thimbleio/kit2-led-cube/README.md

The Thimble LED cube kit.

hadware/ - datasheets, PCB design files

learning/ - tutorial content, intended to be viewed on learning.thimble.io

software/ - code examples written for the Arduino IDE

For more info or to subscribe, visit http://www.thimble.io
