thimbleio/kit2-led-cube/hardware/PCB-Main/Cube Main Gerbers/Cube-Main-Ref.jpg

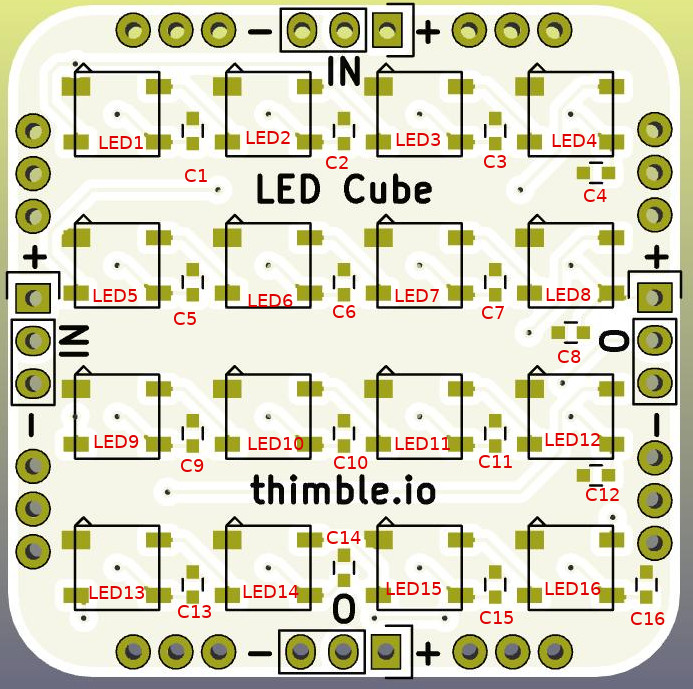
hardware/PCB-Main/Cube Main Gerbers/Cube-Main-Ref.jpg
