thimbleio/kit2-led-cube/hardware/PCB-Top/Cube Top Gerbers/Cube-Top-Ref.jpg

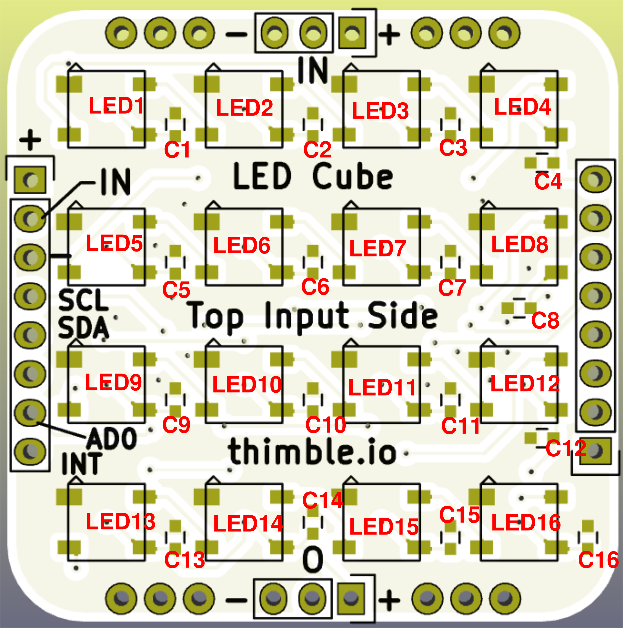
hardware/PCB-Top/Cube Top Gerbers/Cube-Top-Ref.jpg
