thimbleio/kit2-led-cube/learning/assets/images/screenshots/008/in-and-out.png

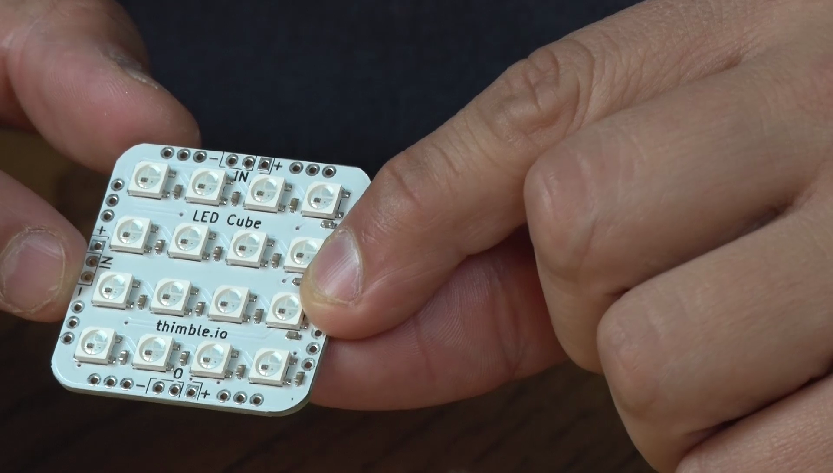
learning/assets/images/screenshots/008/in-and-out.png
