thimbleio/kit2-led-cube/learning/assets/images/thumbs/004.jpg

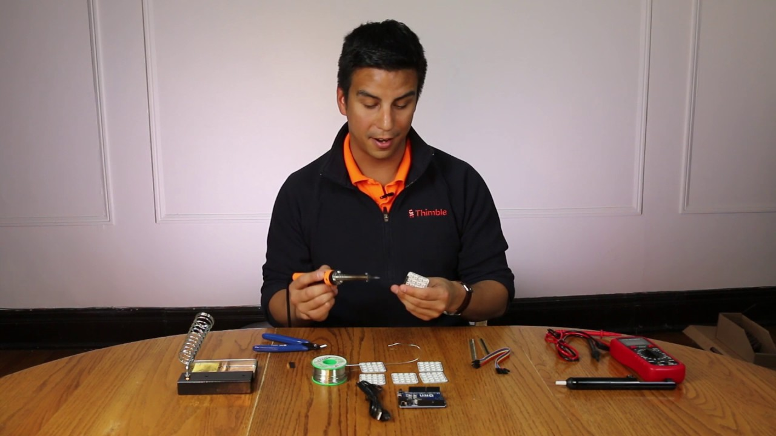
learning/assets/images/thumbs/004.jpg
