thimbleio/kit2-led-cube/learning/assets/images/thumbs/005.jpg

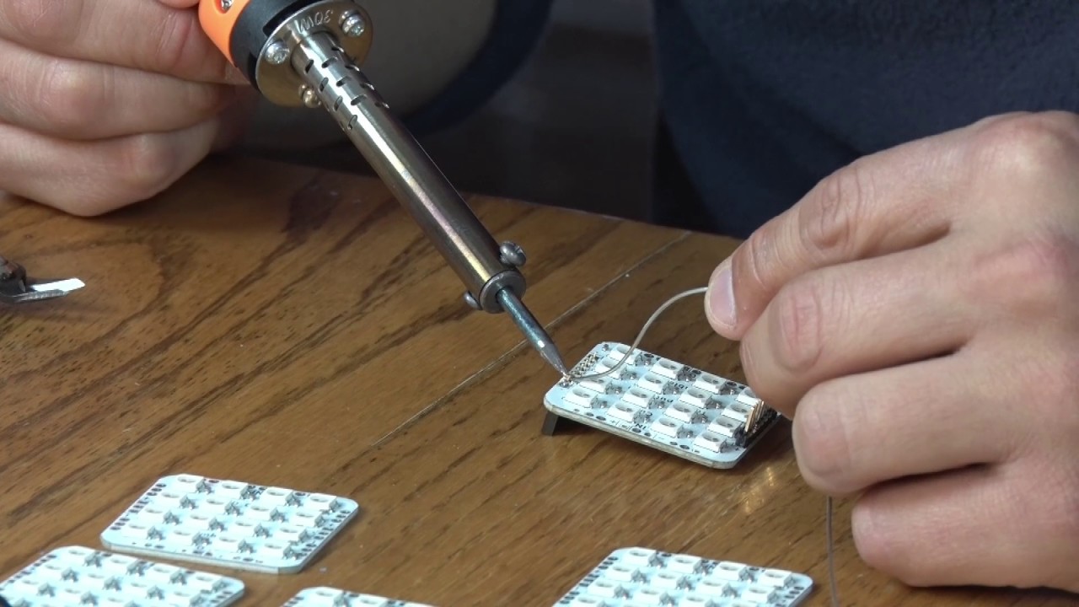
learning/assets/images/thumbs/005.jpg
