thimbleio/kit2-led-cube/learning/assets/images/tools/glue-gun2.jpg

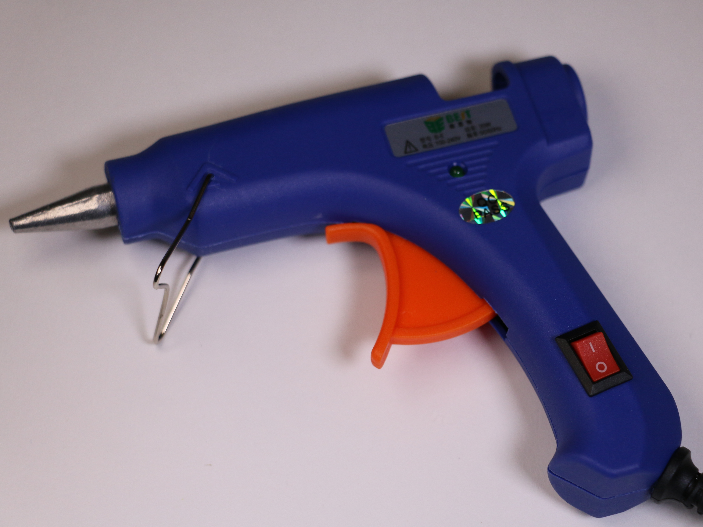
learning/assets/images/tools/glue-gun2.jpg
