thimbleio/kit2-led-cube/learning/assets/images/tools/glue-gun.jpg

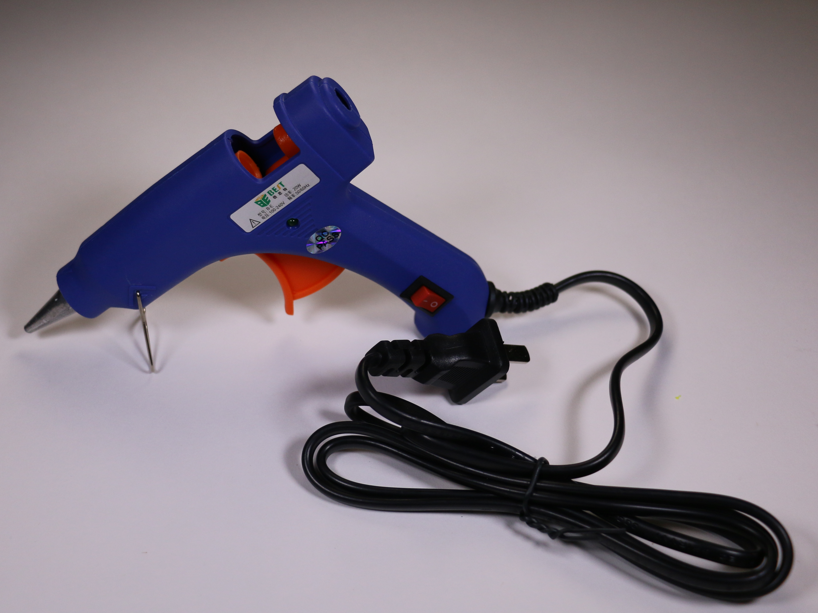
learning/assets/images/tools/glue-gun.jpg
