thimbleio/kit2-led-cube/learning/assets/images/tools/screwdriver2.jpg

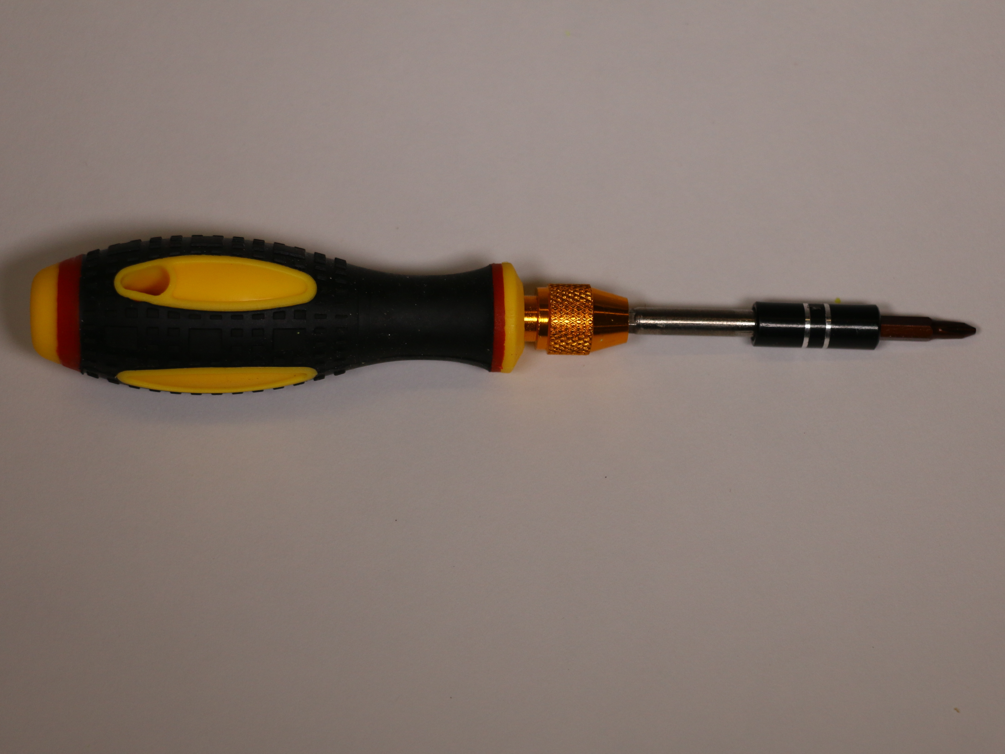
learning/assets/images/tools/screwdriver2.jpg
