thimbleio/kit2-led-cube/learning/assets/images/tools/wire-cutters.jpg

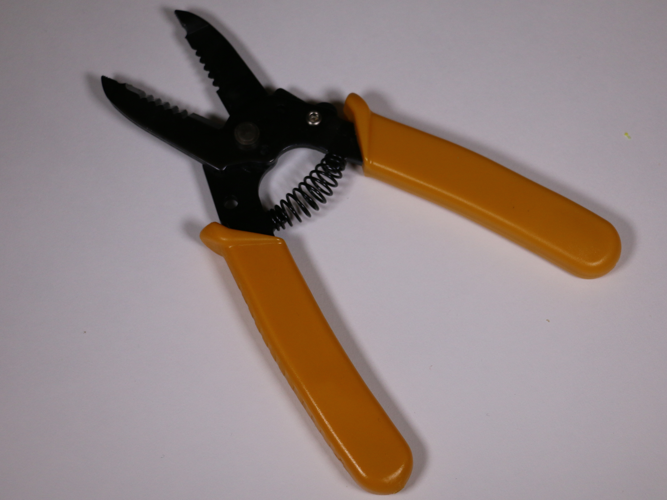
learning/assets/images/tools/wire-cutters.jpg
