thimbleio/kit2-led-cube/learning/assets/images/tools/wire-cutters.png

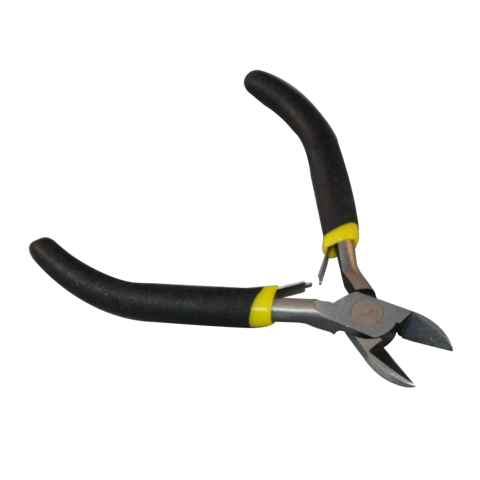
learning/assets/images/tools/wire-cutters.png
