thimbleio/kit2-led-cube/learning/assets/images/tools/solder-sucker.png

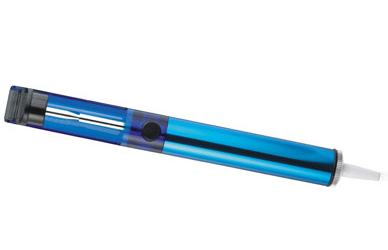
learning/assets/images/tools/solder-sucker.png
