thimbleio/kit2-led-cube/learning/assets/images/tools/solder.png

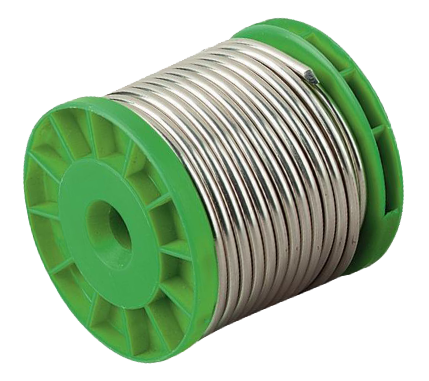
learning/assets/images/tools/solder.png
