thimbleio/kit2-led-cube/learning/assets/images/tools/soldering-iron2.jpg

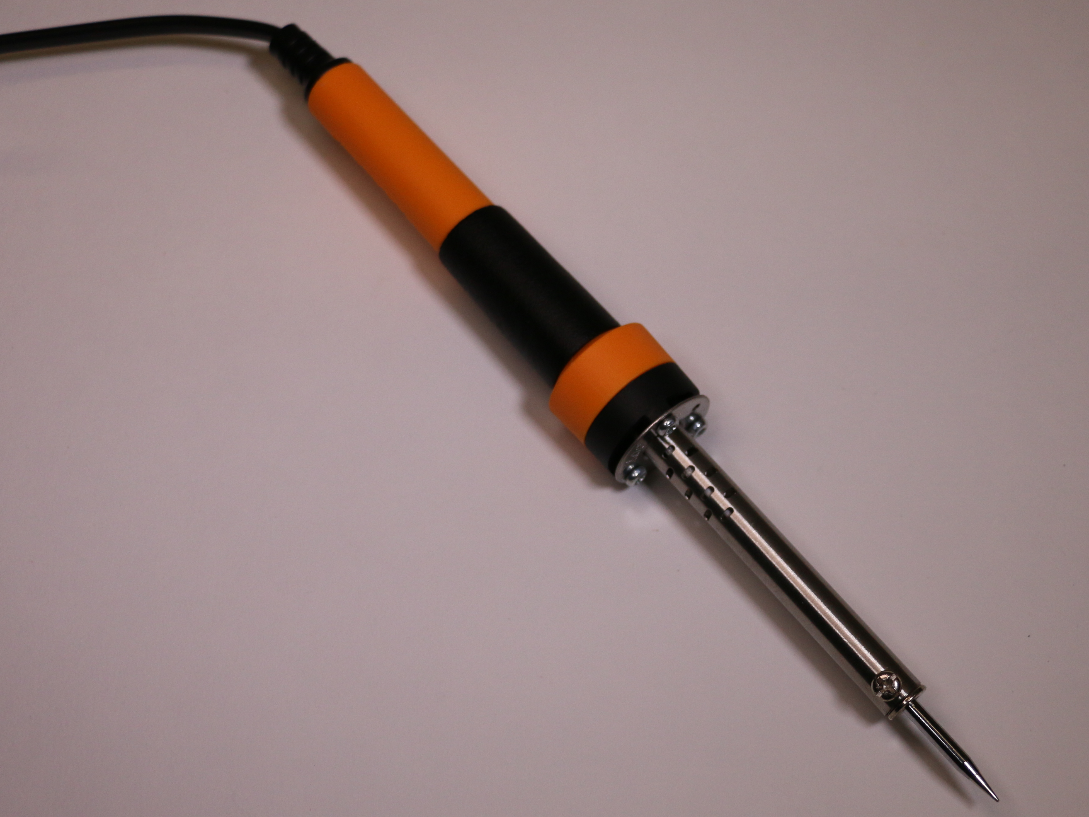
learning/assets/images/tools/soldering-iron2.jpg
