thimbleio/kit2-led-cube/learning/assets/images/tools/soldering-iron-stand2.jpg

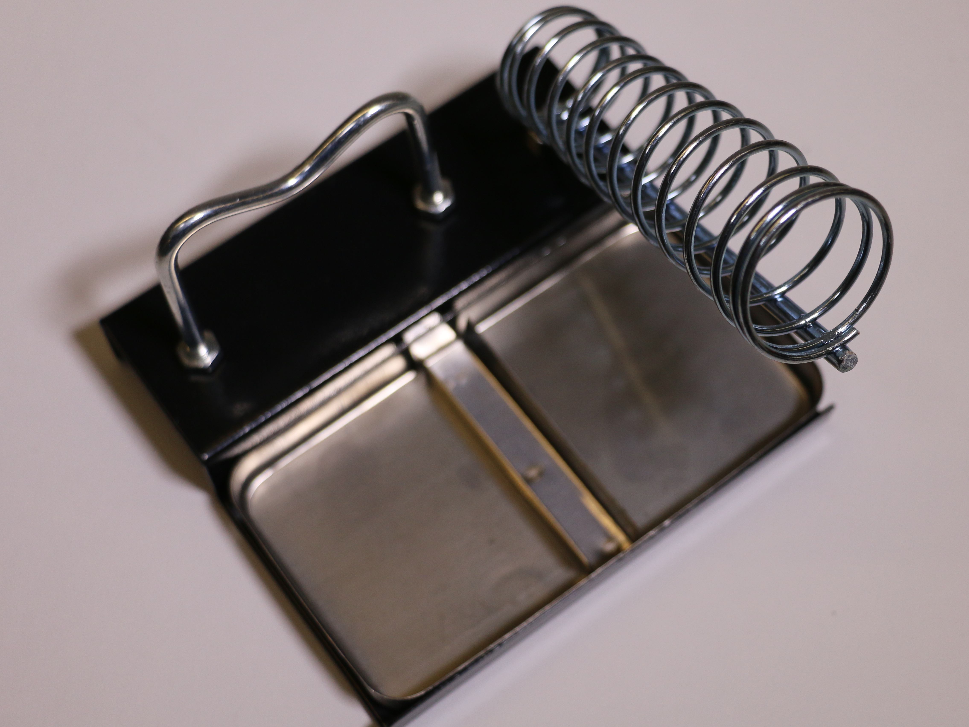
learning/assets/images/tools/soldering-iron-stand2.jpg
