thimbleio/kit2-led-cube/learning/assets/images/tools/soldering-iron-stand.jpg

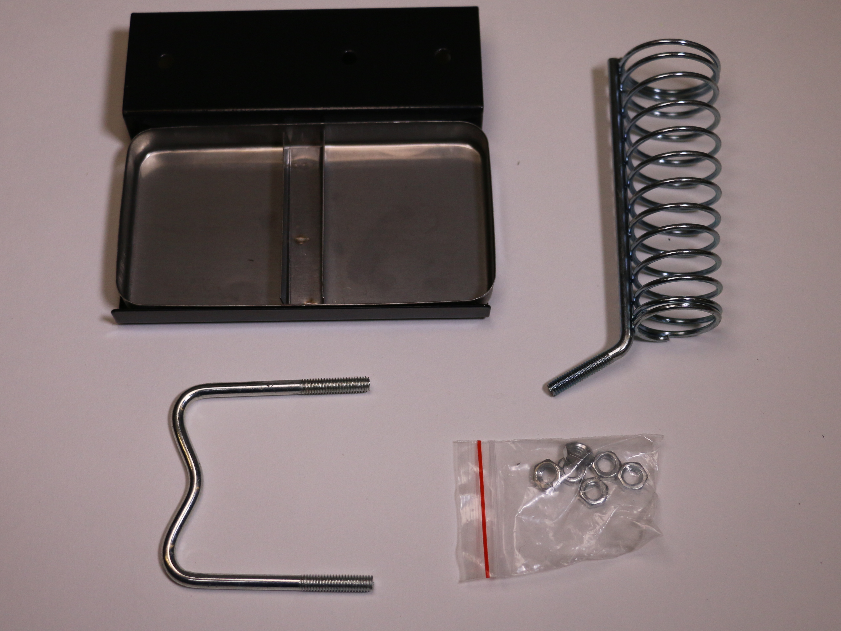
learning/assets/images/tools/soldering-iron-stand.jpg
