thimbleio/kit2-led-cube/learning/assets/images/tools/soldering-iron.png

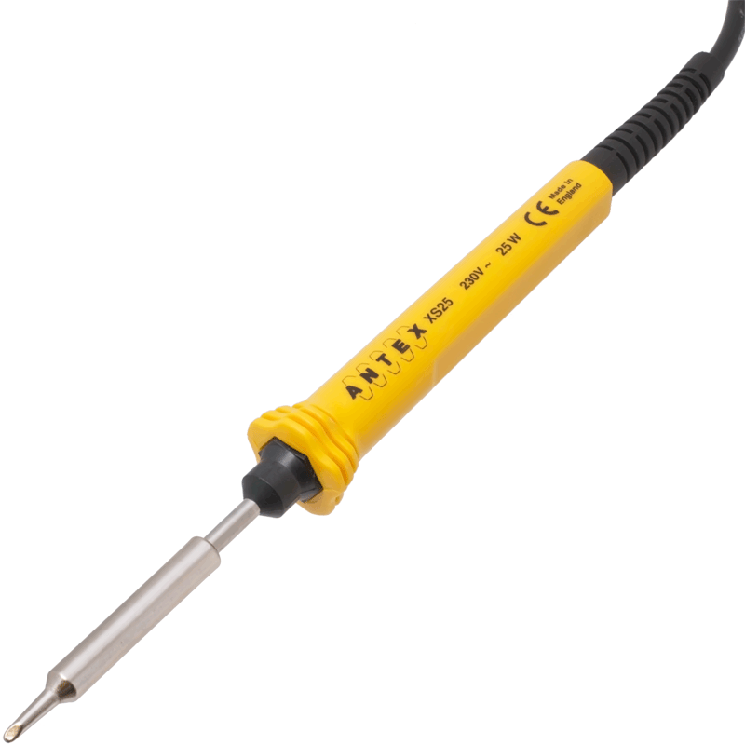
learning/assets/images/tools/soldering-iron.png
