thimbleio/kit2-led-cube/hardware/PCB-Top/led_cube.kicad_pcb

## KiCad design hardware/PCB-Top/led_cube.kicad_pcb (2017-03-08)

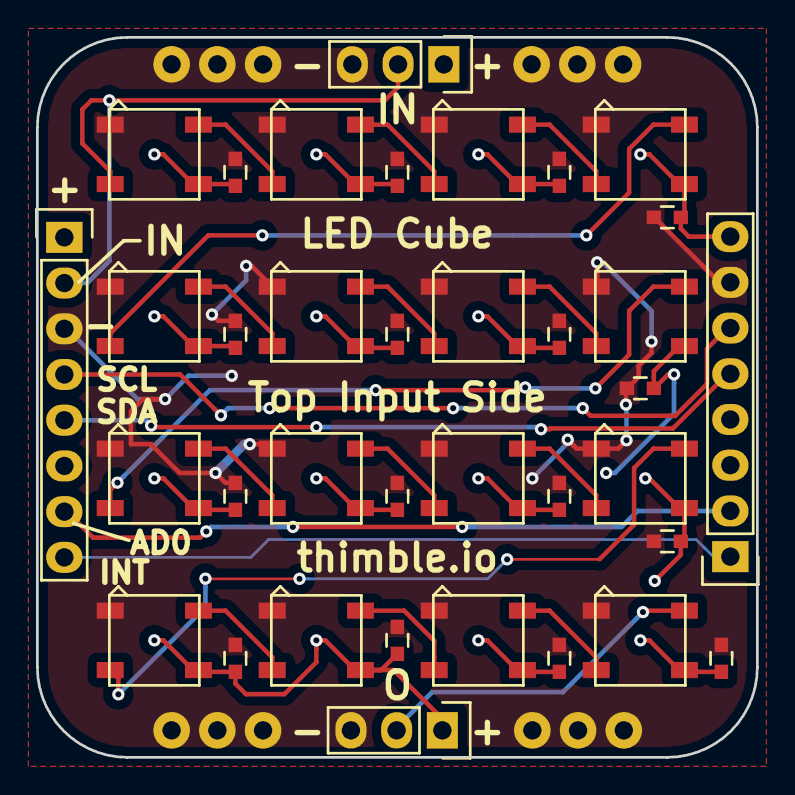
[picture p73: board led_cube.kicad_pcb from above]

Board: 2 copper layers, 40.0 x 40.0 mm, 36 parts (0 on the bottom side), 23 nets.

Parts:
C1, C2, C3, C4, C5, C6, C7, C8, C9, C10, C11, C12, C13, C14, C15, C16: 1uF; C_0603
LED1, LED2, LED3, LED4, LED5, LED6, LED7, LED8, LED9, LED10, LED11, LED12, LED13, LED14, LED15, LED16: LED_RGB_WS2812B; 5050
P1, P4: CONN_01X03; Pin_Header_Straight_1x03
P2, P3: CONN_01X08; Pin_Header_Straight_1x08

Connections:
+5V: C1.1, C2.1, C3.1, C4.1, C5.1, C6.1, C7.1, C8.1, C9.1, C10.1, C11.1, C12.1, C13.1, C14.1, C15.1, C16.1, LED1.1, LED2.1, LED3.1, LED4.1, LED5.1, LED6.1, LED7.1, LED8.1, LED9.1, LED10.1, LED11.1, LED12.1, LED13.1, LED14.1, LED15.1, LED16.1, P1.1, P2.1, P3.8, P4.1
/AD0: P2.7, P3.2
/INT: P2.8, P3.1
/SCL: P2.4, P3.6
/SDA: P2.5, P3.5
GND: C1.2, C2.2, C3.2, C4.2, C5.2, C6.2, C7.2, C8.2, C9.2, C10.2, C11.2, C12.2, C13.2, C14.2, C15.2, C16.2, LED1.3, LED2.3, LED3.3, LED4.3, LED5.3, LED6.3, LED7.3, LED8.3, LED9.3, LED10.3, LED11.3, LED12.3, LED13.3, LED14.3, LED15.3, LED16.3, P1.3, P2.3, P3.7, P4.3
unnamed: LED1.2, LED2.4
unnamed: LED1.4, P1.2, P2.2
unnamed: LED2.2, LED3.4
unnamed: LED3.2, LED4.4
unnamed: LED4.2, LED5.4
unnamed: LED5.2, LED6.4
unnamed: LED6.2, LED7.4
unnamed: LED7.2, LED8.4
unnamed: LED8.2, LED9.4
unnamed: LED10.2, LED11.4
unnamed: LED9.2, LED10.4
unnamed: LED11.2, LED12.4
unnamed: LED12.2, LED13.4
unnamed: LED13.2, LED14.4
unnamed: LED14.2, LED15.4
unnamed: LED15.2, LED16.4
unnamed: LED16.2, P4.2
