thimbleio/kit2-led-cube/(commit log)

2017-03-08 Initial public relase.
    [led_cube-B.Cu.gbl, led_cube-B.Mask.gbs, led_cube-B.Paste.gbp, led_cube-B.SilkS.gbo, led_cube-F.Cu.gtl, led_cube-F.Mask.gts, led_cube-F.Paste.gtp, led_cube-F.SilkS.gbo]
2017-03-08 Add links to github for code samples
2017-03-10 schematic: make background color white
